ervanalb/flowerpower/board/flowerpower.kicad_pcb

## KiCad design board/flowerpower.kicad_pcb (2020-10-18)

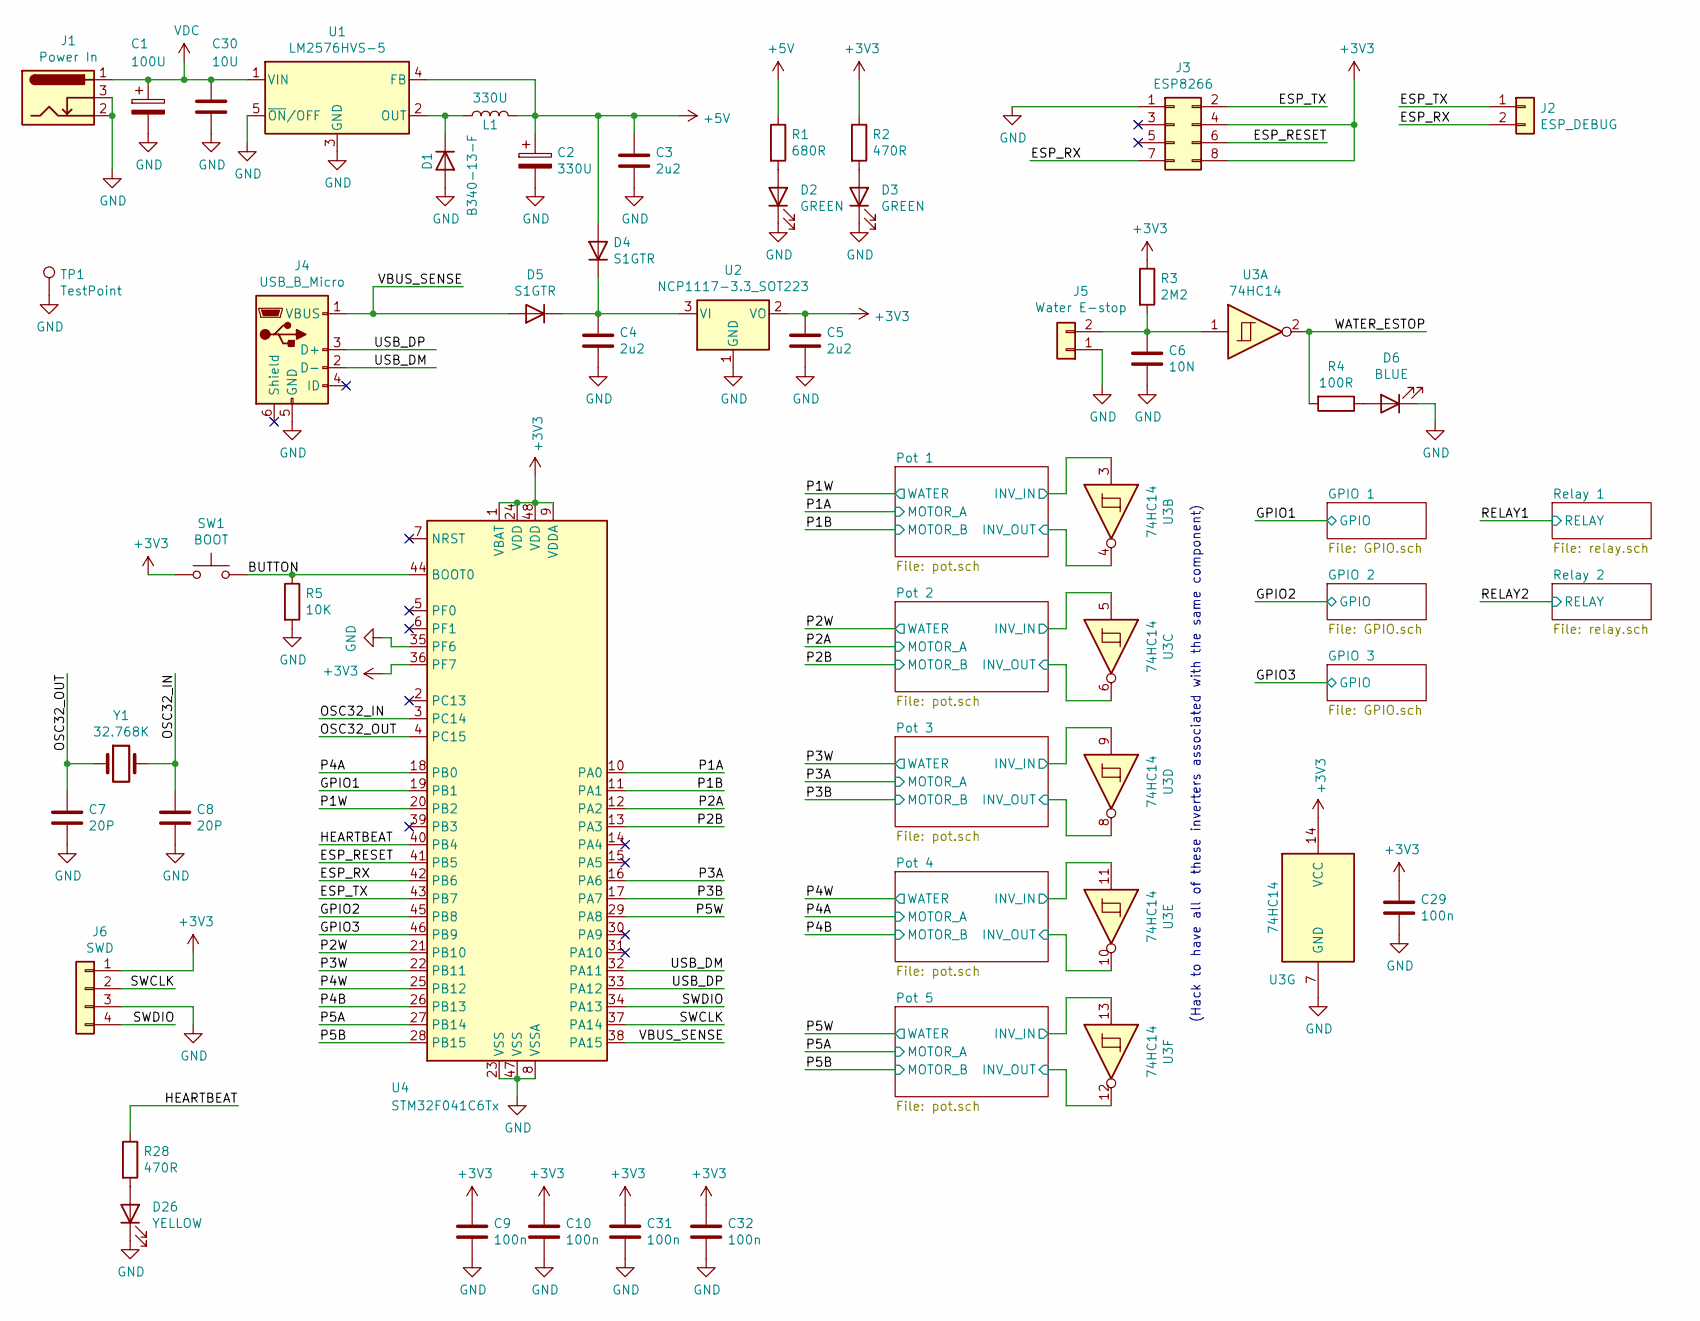
[picture p1: schematic flowerpower.sch]

Parts:
C1: 100U; c_elec_10x10
C2: 330U; c_elec_10x10
C3, C4, C5: 2u2; C_0805
C6: 10N; C_0603
C7, C8: 20P; C_0603
C9, C10, C29, C31, C32: 100n; C_0603
C30: 10U; C_1206
D1: B340-13-F; SMC_Standard
D2, D3: GREEN; LED_0603
D4, D5: S1GTR; SMA_Standard
D6: BLUE; LED_0603
D26: YELLOW; LED_0603
J1: Power In; BARREL_JACK
J2: ESP_DEBUG; Pin_Header_Straight_1x02
J3: ESP8266; Pin_Header_Straight_2x04
J4: USB_B_Micro; USB_Micro-B
J5: Water E-stop; Pin_Header_Straight_1x02
J6: SWD; Pin_Header_Straight_1x04
L1: 330U; toroid_14.2_32.5dia
R1: 680R; R_0603
R2, R28: 470R; R_0603
R3: 2M2; R_0603
R4: 100R; R_0603
R5: 10K; R_0603
SW1: BOOT; SW_SPST_TL3342
TP1: TestPoint; Pin_Header_Straight_1x01
U1: LM2576HVS-5; TO-263-5Lead
U2: NCP1117-3.3_SOT223; SOT-223
U3: 74HC14; SOIC-14_3.9x8.7mm_Pitch1.27mm
U4: STM32F041C6Tx; LQFP-48_7x7mm_Pitch0.5mm
Y1: 32.768K; SOJ-4

Connections:
+3V3: C5.1, C9.1, C10.1, C29.1, C31.1, C32.1, J3.4, J3.8, J6.1, R2.1, R3.1, SW1.1, U2.2 (VO), U3.14 (VCC), U4.1 (VBAT), U4.9 (VDDA), U4.24 (VDD), U4.36 (PF7), U4.48 (VDD); also elsewhere on the board
+5V: C2.1, C3.1, D4.2 (A), L1.2, R1.1, U1.4 (FB); also elsewhere on the board
/BUTTON: R5.1, SW1.2, U4.44 (BOOT0)
/ESP_RESET: J3.6, U4.41 (PB5)
/ESP_RX: J2.2, J3.7, U4.42 (PB6)
/ESP_TX: J2.1, J3.2, U4.43 (PB7)
/GPIO1: U4.19 (PB1); also elsewhere on the board
/GPIO2: U4.45 (PB8); also elsewhere on the board
/GPIO3: U4.46 (PB9); also elsewhere on the board
/HEARTBEAT: R28.1, U4.40 (PB4)
/OSC32_IN: C8.1, U4.3 (PC14), Y1.2
/OSC32_OUT: C7.1, U4.4 (PC15), Y1.1
/P1A: U4.10 (PA0); also elsewhere on the board
/P1B: U4.11 (PA1); also elsewhere on the board
/P1W: U3.4, U4.20 (PB2); also elsewhere on the board
/P2A: U4.12 (PA2); also elsewhere on the board
/P2B: U4.13 (PA3); also elsewhere on the board
/P2W: U3.6, U4.21 (PB10); also elsewhere on the board
/P3A: U4.16 (PA6); also elsewhere on the board
/P3B: U4.17 (PA7); also elsewhere on the board
/P3W: U3.8, U4.22 (PB11); also elsewhere on the board
/P4A: U4.18 (PB0); also elsewhere on the board
/P4B: U4.26 (PB13); also elsewhere on the board
/P4W: U3.10, U4.25 (PB12); also elsewhere on the board
/P5A: U4.27 (PB14); also elsewhere on the board
/P5B: U4.28 (PB15); also elsewhere on the board
/P5W: U3.12, U4.29 (PA8); also elsewhere on the board
/Pot 1/INV_IN: U3.3; also elsewhere on the board
/Pot 2/INV_IN: U3.5; also elsewhere on the board
/Pot 3/INV_IN: U3.9; also elsewhere on the board
/Pot 4/INV_IN: U3.11; also elsewhere on the board
/Pot 5/INV_IN: U3.13; also elsewhere on the board
/SWCLK: J6.2, U4.37 (PA14)
/SWDIO: J6.4, U4.34 (PA13)
/USB_DM: J4.2 (D-), U4.32 (PA11)
/USB_DP: J4.3 (D+), U4.33 (PA12)
/VBUS_SENSE: D5.2 (A), J4.1 (VBUS), U4.38 (PA15)
/WATER_ESTOP: R4.2, U3.2
GND: C1.2, C2.2, C3.2, C4.2, C5.2, C6.2, C7.2, C8.2, C9.2, C10.2, C29.2, C30.2, C31.2, C32.2, D1.2 (A), D2.1 (K), D3.1 (K), D6.1 (K), D26.1 (K), J1.2, J1.3, J3.1, J4.5 (GND), J5.1, J6.3, R5.2, TP1.1, U1.3 (GND), U1.5 (~ON~/OFF), U2.1 (GND), U3.7 (GND), U4.8 (VSSA), U4.23 (VSS), U4.35 (PF6), U4.47 (VSS); also elsewhere on the board
unnamed: C4.1, D4.1 (K), D5.1 (K), U2.3 (VI)
unnamed: C6.1, J5.2, R3.2, U3.1
unnamed: D1.1 (K), L1.1, U1.2 (OUT)
unnamed: D2.2 (A), R1.2
unnamed: D3.2 (A), R2.2
unnamed: D6.2 (A), R4.1
unnamed: D26.2 (A), R28.2
VDC: C1.1, C30.1, J1.1, U1.1 (VIN); also elsewhere on the board

Notes on the sheet:
(Hack to have all of these inverters associated with the same component)

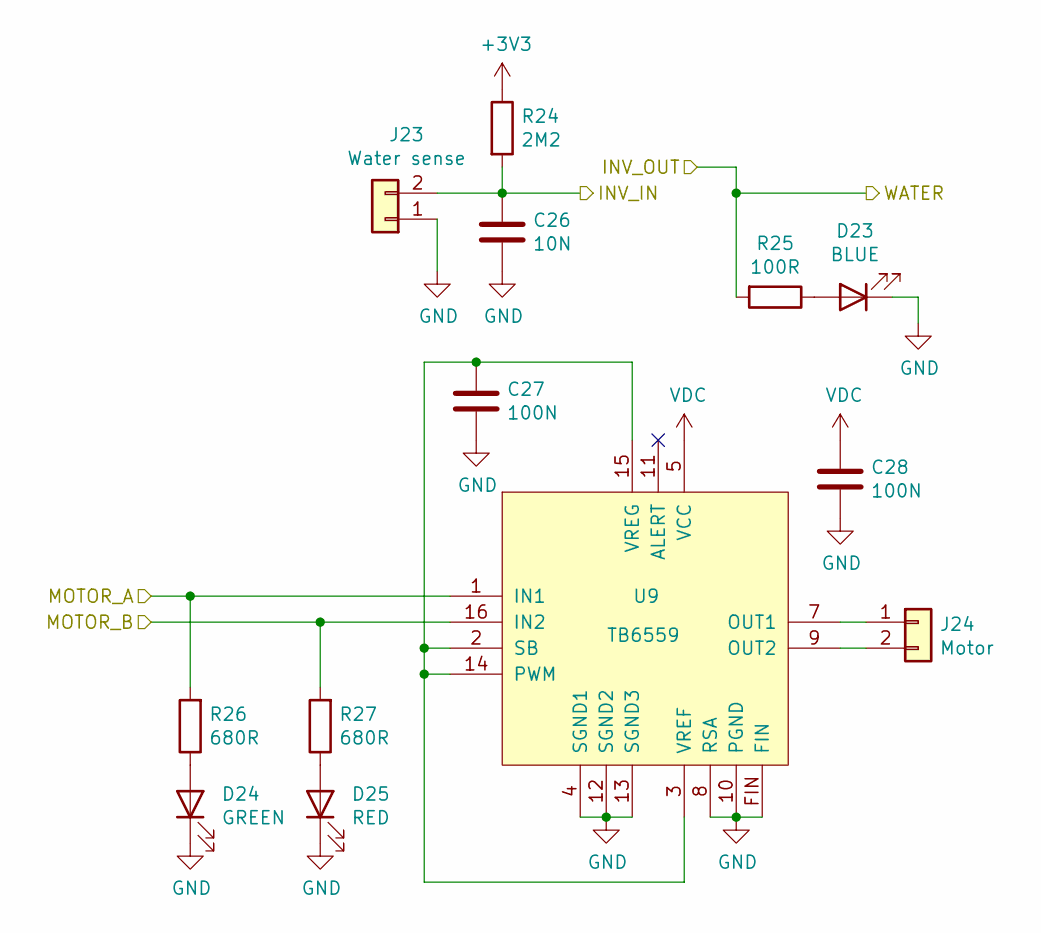
[picture p2: schematic pot.sch]

Parts:
C11: 10N; C_0603
C12, C13: 100N; C_0603
D7: BLUE; LED_0603
D8: GREEN; LED_0603
D9: RED; LED_0603
J7: Water sense; Pin_Header_Straight_1x02
J8: Motor; Pin_Header_Straight_1x02
R6: 2M2; R_0603
R7: 100R; R_0603
R8, R9: 680R; R_0603
U5: TB6559; 16-hsop-fins

Connections:
+3V3: R6.1; also elsewhere on the board
/P1A: R8.2, U5.1 (IN1); also elsewhere on the board
/P1B: R9.2, U5.16 (IN2); also elsewhere on the board
/P1W: R7.2; also elsewhere on the board
/Pot 1/INV_IN: C11.1, J7.2, R6.2; also elsewhere on the board
GND: C11.2, C12.2, C13.2, D7.1 (K), D8.1 (K), D9.1 (K), J7.1, U5.4 (SGND1), U5.8 (RSA), U5.10 (PGND), U5.12 (SGND2), U5.13 (SGND3), U5.FIN; also elsewhere on the board
unnamed: C12.1, U5.2 (SB), U5.3 (VREF), U5.14 (PWM), U5.15 (VREG)
unnamed: D7.2 (A), R7.1
unnamed: D8.2 (A), R8.1
unnamed: D9.2 (A), R9.1
unnamed: J8.1, U5.7 (OUT1)
unnamed: J8.2, U5.9 (OUT2)
VDC: C13.1, U5.5 (VCC); also elsewhere on the board

Parts of its further copies:
C17, C20, C23, C26: 10N; C_0603
C18, C19, C21, C22, C24, C25, C27, C28: 100N; C_0603
D14, D17, D20, D23: BLUE; LED_0603
D15, D18, D21, D24: GREEN; LED_0603
D16, D19, D22, D25: RED; LED_0603
J17, J19, J21, J23: Water sense; Pin_Header_Straight_1x02
J18, J20, J22, J24: Motor; Pin_Header_Straight_1x02
R12, R16, R20, R24: 2M2; R_0603
R13, R17, R21, R25: 100R; R_0603
R14, R15, R18, R19, R22, R23, R26, R27: 680R; R_0603
U6, U7, U8, U9: TB6559; 16-hsop-fins

Connections of its further copies:
+3V3: R12.1, R16.1, R20.1, R24.1; also elsewhere on the board
/P2A: R14.2, U6.1 (IN1); also elsewhere on the board
/P2B: R15.2, U6.16 (IN2); also elsewhere on the board
/P2W: R13.2; also elsewhere on the board
/P3A: R18.2, U7.1 (IN1); also elsewhere on the board
/P3B: R19.2, U7.16 (IN2); also elsewhere on the board
/P3W: R17.2; also elsewhere on the board
/P4A: R22.2, U8.1 (IN1); also elsewhere on the board
/P4B: R23.2, U8.16 (IN2); also elsewhere on the board
/P4W: R21.2; also elsewhere on the board
/P5A: R26.2, U9.1 (IN1); also elsewhere on the board
/P5B: R27.2, U9.16 (IN2); also elsewhere on the board
/P5W: R25.2; also elsewhere on the board
/Pot 2/INV_IN: C17.1, J17.2, R12.2; also elsewhere on the board
/Pot 3/INV_IN: C20.1, J19.2, R16.2; also elsewhere on the board
/Pot 4/INV_IN: C23.1, J21.2, R20.2; also elsewhere on the board
/Pot 5/INV_IN: C26.1, J23.2, R24.2; also elsewhere on the board
GND: C17.2, C18.2, C19.2, C20.2, C21.2, C22.2, C23.2, C24.2, C25.2, C26.2, C27.2, C28.2, D14.1 (K), D15.1 (K), D16.1 (K), D17.1 (K), D18.1 (K), D19.1 (K), D20.1 (K), D21.1 (K), D22.1 (K), D23.1 (K), D24.1 (K), D25.1 (K), J17.1, J19.1, J21.1, J23.1, U6.4 (SGND1), U6.8 (RSA), U6.10 (PGND), U6.12 (SGND2), U6.13 (SGND3), U6.FIN, U7.4 (SGND1), U7.8 (RSA), U7.10 (PGND), U7.12 (SGND2), U7.13 (SGND3), U7.FIN, U8.4 (SGND1), U8.8 (RSA), U8.10 (PGND), U8.12 (SGND2), U8.13 (SGND3), U8.FIN, U9.4 (SGND1), U9.8 (RSA), U9.10 (PGND), U9.12 (SGND2), U9.13 (SGND3), U9.FIN; also elsewhere on the board
unnamed: C18.1, U6.2 (SB), U6.3 (VREF), U6.14 (PWM), U6.15 (VREG)
unnamed: C21.1, U7.2 (SB), U7.3 (VREF), U7.14 (PWM), U7.15 (VREG)
unnamed: C24.1, U8.2 (SB), U8.3 (VREF), U8.14 (PWM), U8.15 (VREG)
unnamed: C27.1, U9.2 (SB), U9.3 (VREF), U9.14 (PWM), U9.15 (VREG)
unnamed: D14.2 (A), R13.1
unnamed: D15.2 (A), R14.1
unnamed: D16.2 (A), R15.1
unnamed: D17.2 (A), R17.1
unnamed: D18.2 (A), R18.1
unnamed: D19.2 (A), R19.1
unnamed: D20.2 (A), R21.1
unnamed: D21.2 (A), R22.1
unnamed: D22.2 (A), R23.1
unnamed: D23.2 (A), R25.1
unnamed: D24.2 (A), R26.1
unnamed: D25.2 (A), R27.1
unnamed: J18.1, U6.7 (OUT1)
unnamed: J18.2, U6.9 (OUT2)
unnamed: J20.1, U7.7 (OUT1)
unnamed: J20.2, U7.9 (OUT2)
unnamed: J22.1, U8.7 (OUT1)
unnamed: J22.2, U8.9 (OUT2)
unnamed: J24.1, U9.7 (OUT1)
unnamed: J24.2, U9.9 (OUT2)
VDC: C19.1, C22.1, C25.1, C28.1, U6.5 (VCC), U7.5 (VCC), U8.5 (VCC), U9.5 (VCC); also elsewhere on the board

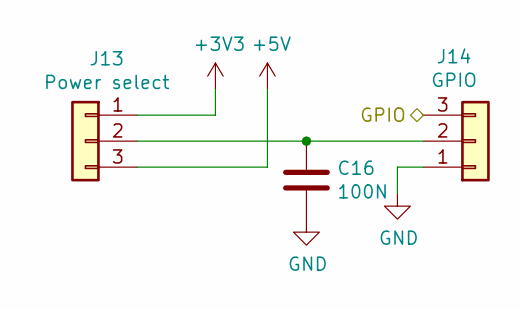
[picture p3: schematic GPIO.sch]

Parts:
C14: 100N; C_0603
J9: Power select; Pin_Header_Straight_1x03
J10: GPIO; Pin_Header_Straight_1x03

Connections:
+3V3: J9.1; also elsewhere on the board
+5V: J9.3; also elsewhere on the board
/GPIO1: J10.3; also elsewhere on the board
GND: C14.2, J10.1; also elsewhere on the board
unnamed: C14.1, J9.2, J10.2

Parts of its further copies:
C15, C16: 100N; C_0603
J11, J13: Power select; Pin_Header_Straight_1x03
J12, J14: GPIO; Pin_Header_Straight_1x03

Connections of its further copies:
+3V3: J11.1, J13.1; also elsewhere on the board
+5V: J11.3, J13.3; also elsewhere on the board
/GPIO2: J12.3; also elsewhere on the board
/GPIO3: J14.3; also elsewhere on the board
GND: C15.2, C16.2, J12.1, J14.1; also elsewhere on the board
unnamed: C15.1, J11.2, J12.2
unnamed: C16.1, J13.2, J14.2

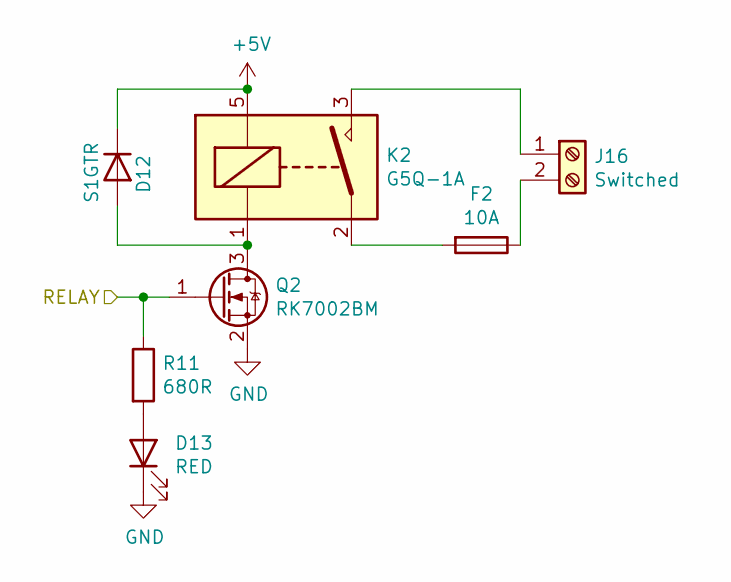
[picture p4: schematic relay.sch]

Parts:
D10: S1GTR; SMA_Standard
D11: RED; LED_0603
F1: 10A; Fuseholder5x20_horiz_SemiClosed_Casing10x25mm
J15: Switched; TerminalBlock_Pheonix_PT-3.5mm_2pol
K1: G5Q-1A; Relay_SPST_Omron-G5Q-1A
Q1: RK7002BM; SOT-23
R10: 680R; R_0603

Connections:
+5V: D10.1 (K), K1.5; also elsewhere on the board
/RELAY1: Q1.1 (G), R10.1
GND: D11.1 (K), Q1.2 (S); also elsewhere on the board
unnamed: D10.2 (A), K1.1, Q1.3 (D)
unnamed: D11.2 (A), R10.2
unnamed: F1.1, J15.2
unnamed: F1.2, K1.2
unnamed: J15.1, K1.3

Parts of its further copies:
D12: S1GTR; SMA_Standard
D13: RED; LED_0603
F2: 10A; Fuseholder5x20_horiz_SemiClosed_Casing10x25mm
J16: Switched; TerminalBlock_Pheonix_PT-3.5mm_2pol
K2: G5Q-1A; Relay_SPST_Omron-G5Q-1A
Q2: RK7002BM; SOT-23
R11: 680R; R_0603

Connections of its further copies:
+5V: D12.1 (K), K2.5; also elsewhere on the board
/RELAY2: Q2.1 (G), R11.1
GND: D13.1 (K), Q2.2 (S); also elsewhere on the board
unnamed: D12.2 (A), K2.1, Q2.3 (D)
unnamed: D13.2 (A), R11.2
unnamed: F2.1, J16.2
unnamed: F2.2, K2.2
unnamed: J16.1, K2.3

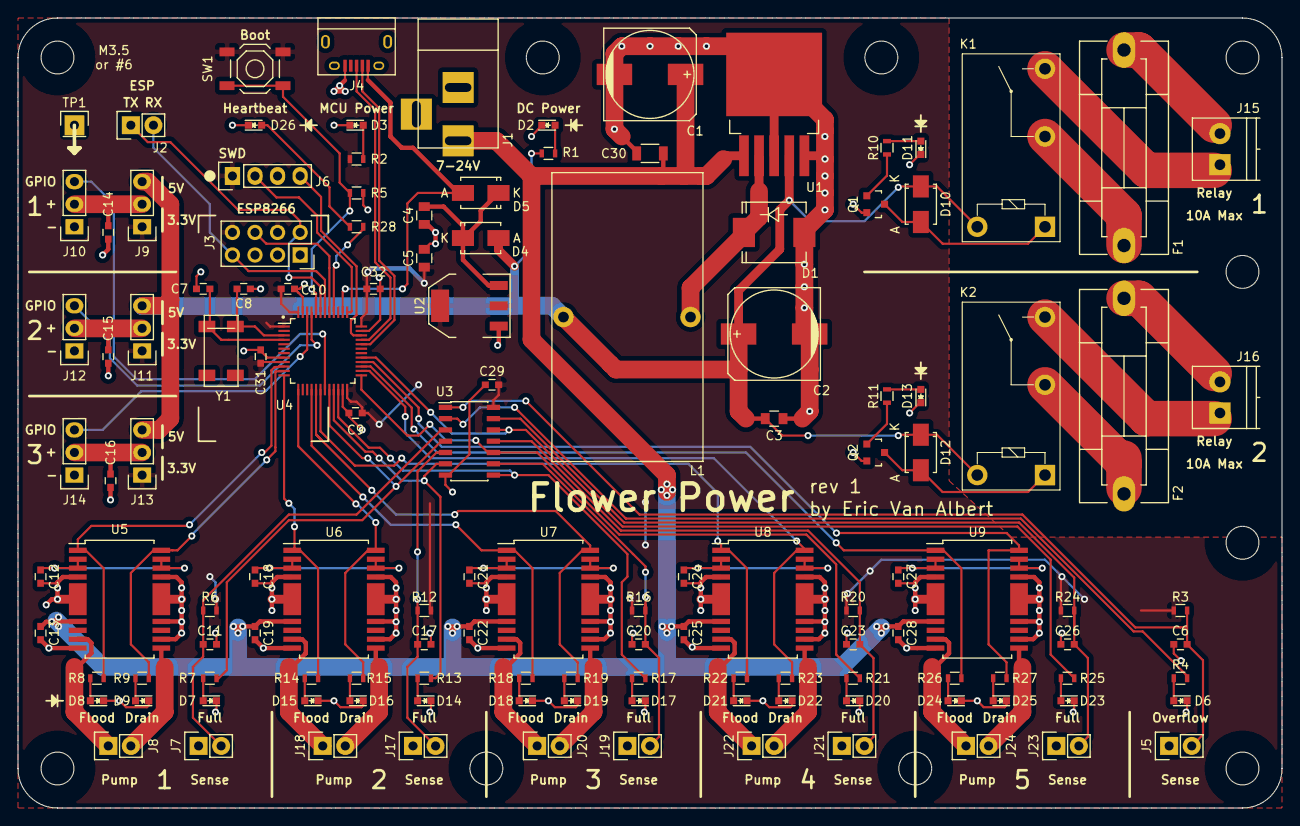
[picture p5: board flowerpower.kicad_pcb from above]

Board: 2 copper layers, 142.2 x 88.9 mm, 129 parts (0 on the bottom side), 92 nets.
