ervanalb/flowerpower/firmware/src/comms.c

#include "comms.h"

#include <FreeRTOS.h>
#include <task.h>
#include <semphr.h>
#include <stdarg.h>
#include <stdio.h>

#include "hal.h"
#include "usb.h"
#include "state_config.h"

#define MAX_MSG_LEN 256
#define TASK_STACK_SIZE 280
#define USB_SEND_TIMEOUT pdMS_TO_TICKS(100)

static SemaphoreHandle_t transmit_semaphore = NULL;

static void on_receive(const char *message, size_t length);

static void receive_task(void *pvParameters) {
    (void)pvParameters;
    static char rx_buf[MAX_MSG_LEN];
    bool invalid = false;

    for (;;) {
        // Right now this is just USB receive.
        // But we may need to create a receive queue if there are multiple sources in the future.
        size_t rx_len = usb_receive(rx_buf, MAX_MSG_LEN);
        // rx_len == MAX_MSG_LEN is invalid because there wasn't room for the NULL terminator,
        // which is requried by some receive functions (like sscanf)
        if (rx_len < MAX_MSG_LEN || rx_buf[rx_len - 1] == '\n') {
            if (!invalid) {
                on_receive(rx_buf, rx_len);
            }
            invalid = false;
        } else {
            // Discard until the next newline if the message is too long
            invalid = true;
        }
    }
}

void comms_init(void) {
    configASSERT(xTaskCreate(receive_task, "comms_receive", TASK_STACK_SIZE, NULL, 1, NULL) == pdTRUE);
    transmit_semaphore = xSemaphoreCreateMutex();
    configASSERT(transmit_semaphore);
}

void comms_send(const char *message, size_t length) {
    configASSERT(xSemaphoreTake(transmit_semaphore, portMAX_DELAY) == pdTRUE);
    usb_transmit(message, length, USB_SEND_TIMEOUT);
    xSemaphoreGive(transmit_semaphore);
}

void comms_printf(const char *fmt, ...) {
    static char buffer[MAX_MSG_LEN];
    va_list arg;
    va_start(arg, fmt);
    int n = vsnprintf(buffer, MAX_MSG_LEN, fmt, arg);
    va_end(arg);
    configASSERT(n >= 0 && n <= MAX_MSG_LEN);
    comms_send(buffer, n);
}

static void on_receive(const char *message, size_t length) {
    state_parse(message, length);
}
