ervanalb/flowerpower/firmware/src/handlers.c

#include <FreeRTOS.h>
#include <task.h>

void vApplicationMallocFailedHook(void);

void vApplicationMallocFailedHook(void) {
    for (;;);
}

void vApplicationStackOverflowHook(TaskHandle_t xTask, char *pcTaskName) {
    (void) xTask;
    (void) pcTaskName;

    for (;;);
}
