ervanalb/flowerpower/(commit log)

2020-09-30 Schematic and some footprint association
    [GPIO.sch, flowerpower.kicad_pcb, flowerpower.sch, pot.sch, relay.sch]
2020-10-04 beginning layout
    [GPIO.sch, flowerpower.kicad_pcb, flowerpower.sch, pot.sch, relay.sch]
2020-10-04 tweaking layout
    [flowerpower.kicad_pcb, flowerpower.sch, pot.sch, relay.sch]
2020-10-05 finish layout
    [flowerpower.kicad_pcb, flowerpower.sch, pot.sch, relay.sch]
2020-10-06 Final tweaks
    [flowerpower.kicad_pcb, flowerpower.sch, pot.sch, relay.sch]
2020-10-06 generate rev1 gerbers
    [flowerpower-B_Cu.gbr, flowerpower-B_Mask.gbr, flowerpower-B_Paste.gbr, flowerpower-B_SilkS.gbr, flowerpower-Edge_Cuts.gbr, flowerpower-F_Cu.gbr, flowerpower-F_Mask.gbr, flowerpower-F_Paste.gbr]
2020-10-09 zipped up gerbs
    [bom.csv]
2020-10-09 Add no-op firmware
    [GPIO.sch, bom.csv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]
2020-10-16 Noodling around with the firmware some more (USB RX seems to be working)
    [flowerpower.kicad_pcb]
2020-10-18 Further refinement with regards to RTC, comms, heartbeat, watchdog
    [flowerpower.kicad_pcb]
2020-10-19 Basic relay setting
2020-10-20 Flash write working (when not debugging) along with relay schedules
2020-10-22 Fix some bugs in the pot filling and draining logic
    [control.c, serialtest.py, state_config.c, state_config.h]
